ocm87/fmcw/README.md

# ELEC4907 FMCW/Dopper Radar Capstone Project
Year: 2024-2025

Supervisor: Shulabh Gupta

Team Members: Carter Livermore, Jin Her, Max Hecht, Owen MacIntosh
