ocm87/fmcw/post_processing/readme.md

This folder hold post processing applications for data received from the MCU over a serial UART connection at 921600 Baud
