ocm87/fmcw/hardware/kicad/CapstoneMCU/CapstoneMCU.step

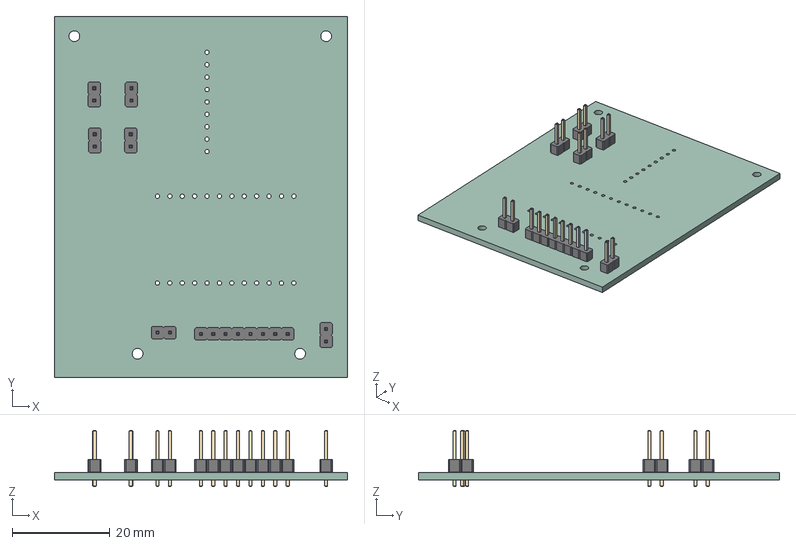
[picture p1: CAD file, 2025-04-09]
hardware/kicad/CapstoneMCU/CapstoneMCU.step
60.0 x 74.0 x 11.5 mm
PinHeader_1x02_P254mm_Vertical x 6
PinHeader_1x08_P254mm_Vertical
CapstoneMCU_PCB
