ocm87/fmcw/hardware/kicad/LF_Hardware/ELEC4907.step

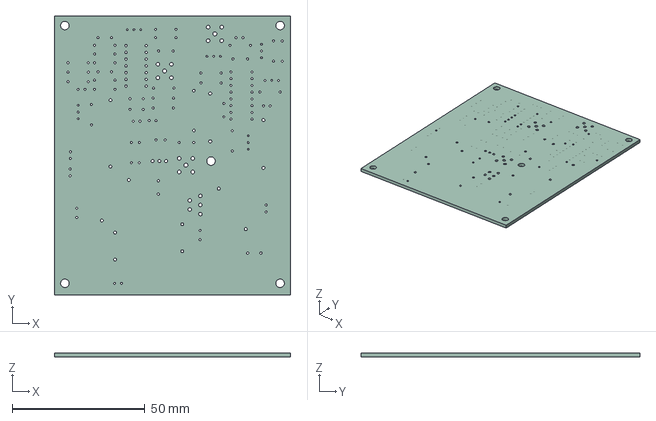
[picture p2: CAD file, 2025-04-09]
hardware/kicad/LF_Hardware/ELEC4907.step
89.0 x 105.0 x 1.60 mm
