ocm87/fmcw/hardware/kicad/symbols_and_footprints/mcu_pcb_symAndfoot/3296W_1_503LF/3296W-1-503LF.step

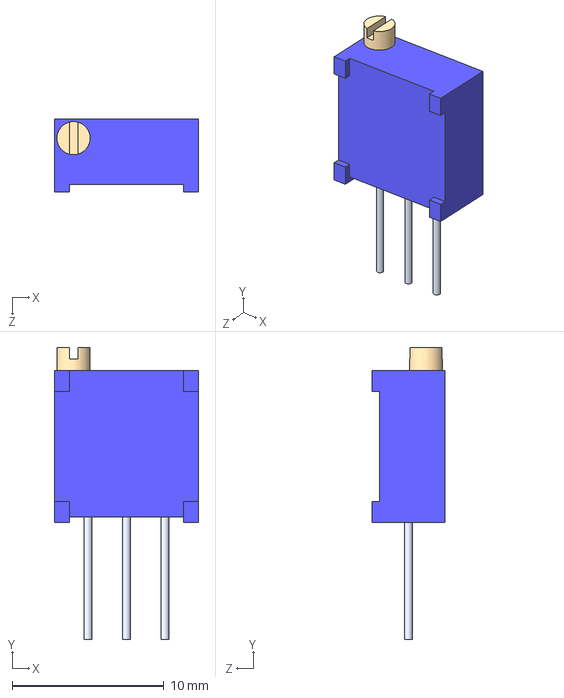
[picture p3: CAD file, 2025-04-09]
hardware/kicad/symbols_and_footprints/mcu_pcb_symAndfoot/3296W_1_503LF/3296W-1-503LF.step
9.53 x 19.3 x 4.83 mm
