ocm87/fmcw/hardware/kicad/symbols_and_footprints/mcu_pcb_symAndfoot/arm_debug_header/arm_debug_header.step

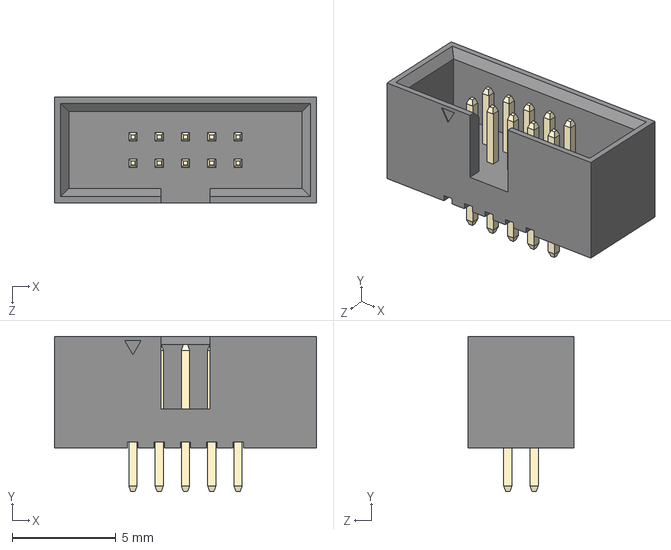
[picture p4: CAD file, 2025-04-09]
hardware/kicad/symbols_and_footprints/mcu_pcb_symAndfoot/arm_debug_header/arm_debug_header.step
12.7 x 7.50 x 5.10 mm
3220-xx-0100-00 body_10
Pin^3220-xx-0100-00 x 10
