ocm87/fmcw/hardware/kicad/symbols_and_footprints/mcu_pcb_symAndfoot/FTSH_105_01_LM_DV_K/FTSH-105-01-LM-DV-TR.step

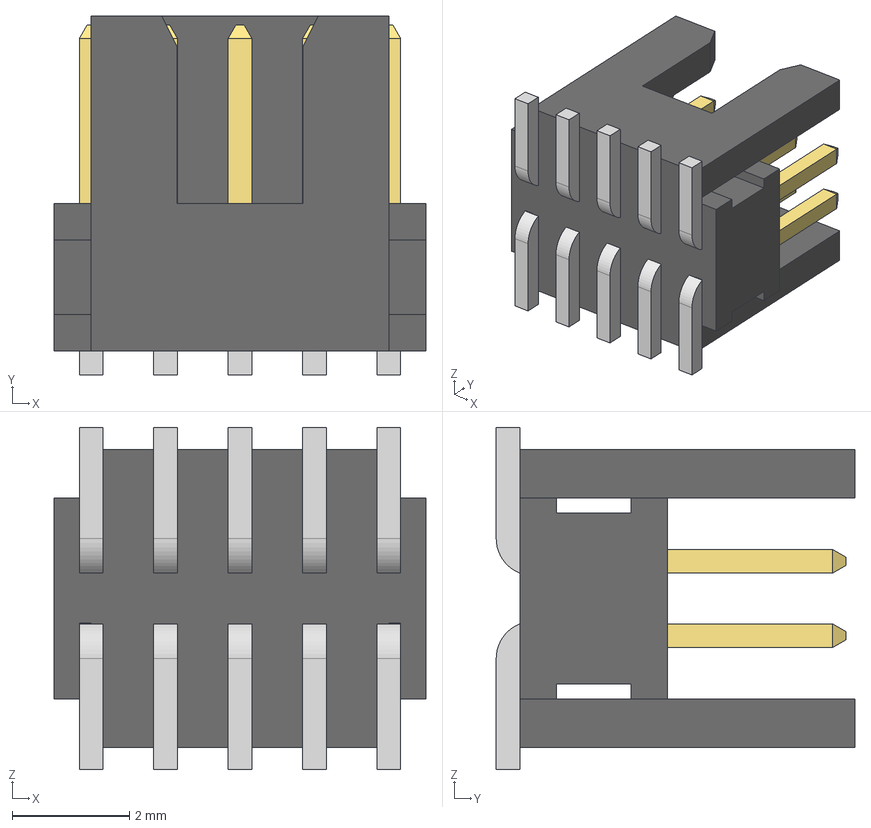
[picture p5: CAD file, 2025-04-09]
hardware/kicad/symbols_and_footprints/mcu_pcb_symAndfoot/FTSH_105_01_LM_DV_K/FTSH-105-01-LM-DV-TR.step
6.35 x 6.12 x 5.84 mm
FTSH-105-01-LM-DV-K_body
FTSH-105-01-LM-DV-K_pins1
FTSH-105-01-LM-DV-K_pins2
