ocm87/fmcw/hardware/kicad/symbols_and_footprints/mcu_pcb_symAndfoot/LT1214CN_PBF/PDIP-14_N_LIT.step

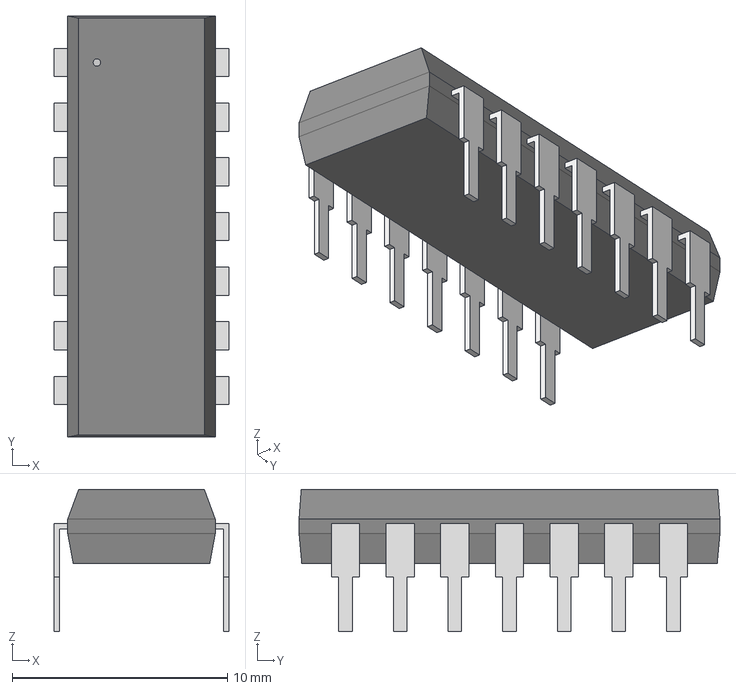
[picture p6: CAD file, 2025-04-09]
hardware/kicad/symbols_and_footprints/mcu_pcb_symAndfoot/LT1214CN_PBF/PDIP-14_N_LIT.step
8.13 x 19.6 x 6.61 mm
