ocm87/fmcw/(list of files, cad)

Other CAD files:
hardware/Top_level v55.f3z
