ocm87/fmcw/hardware/kicad/CapstoneMCU/CapstoneMCU.pdf

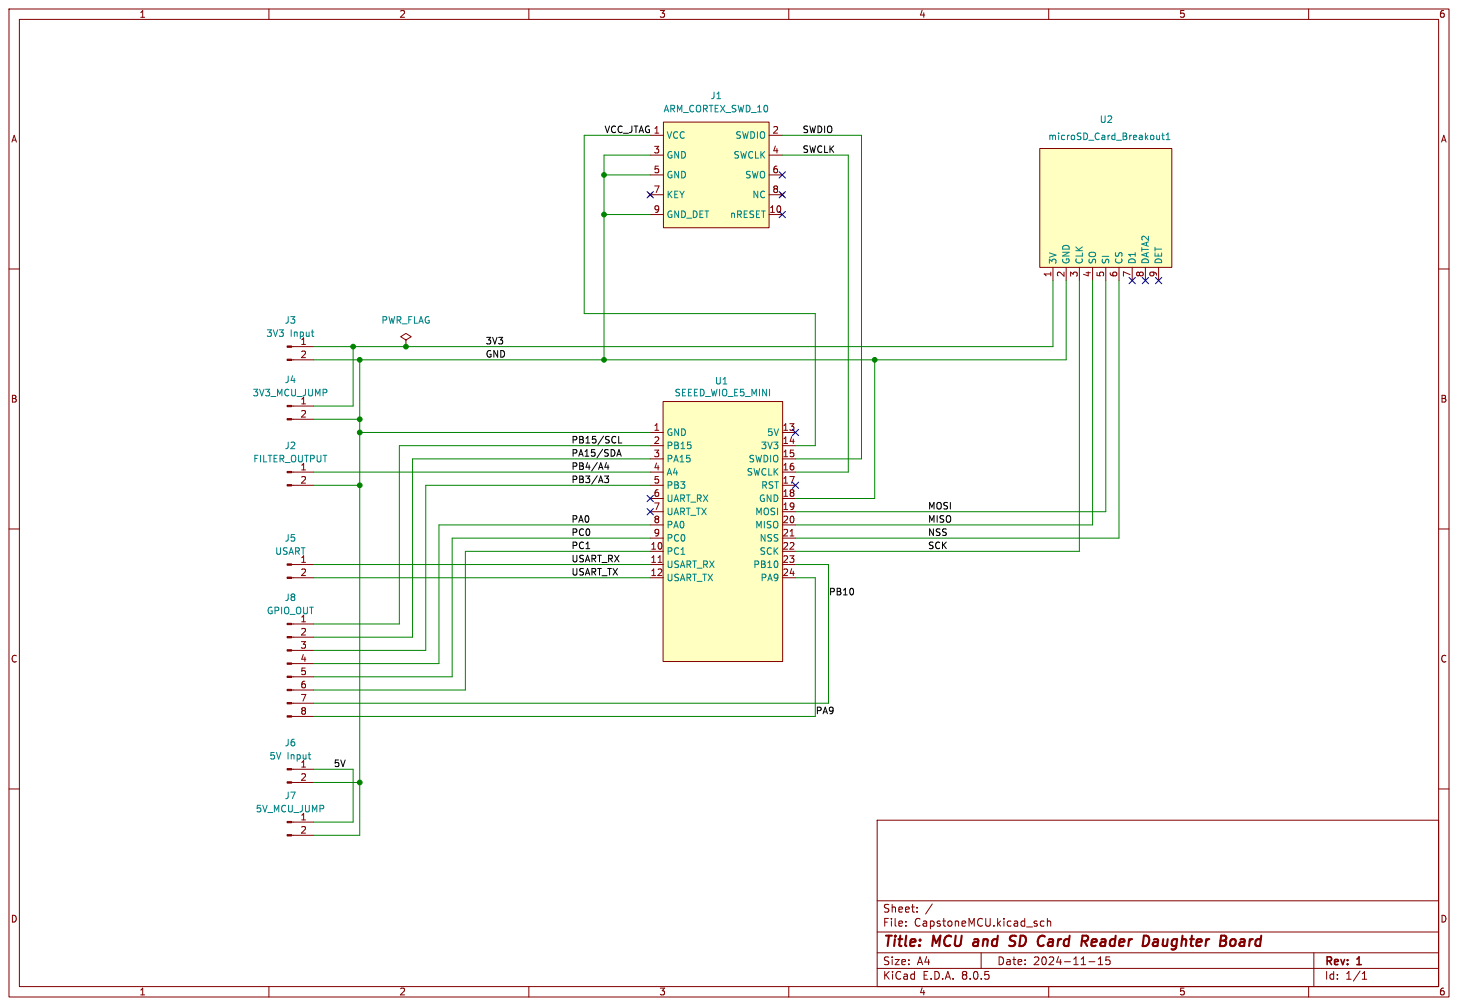
[picture p7: page 1]

Id: 1/1 Title: MCU and SD Card Reader Daughter Board
