ocm87/fmcw/hardware/kicad/LF_Hardware/ELEC4907.kicad_pcb

## KiCad design hardware/kicad/LF_Hardware/ELEC4907.kicad_pcb (2025-04-09)

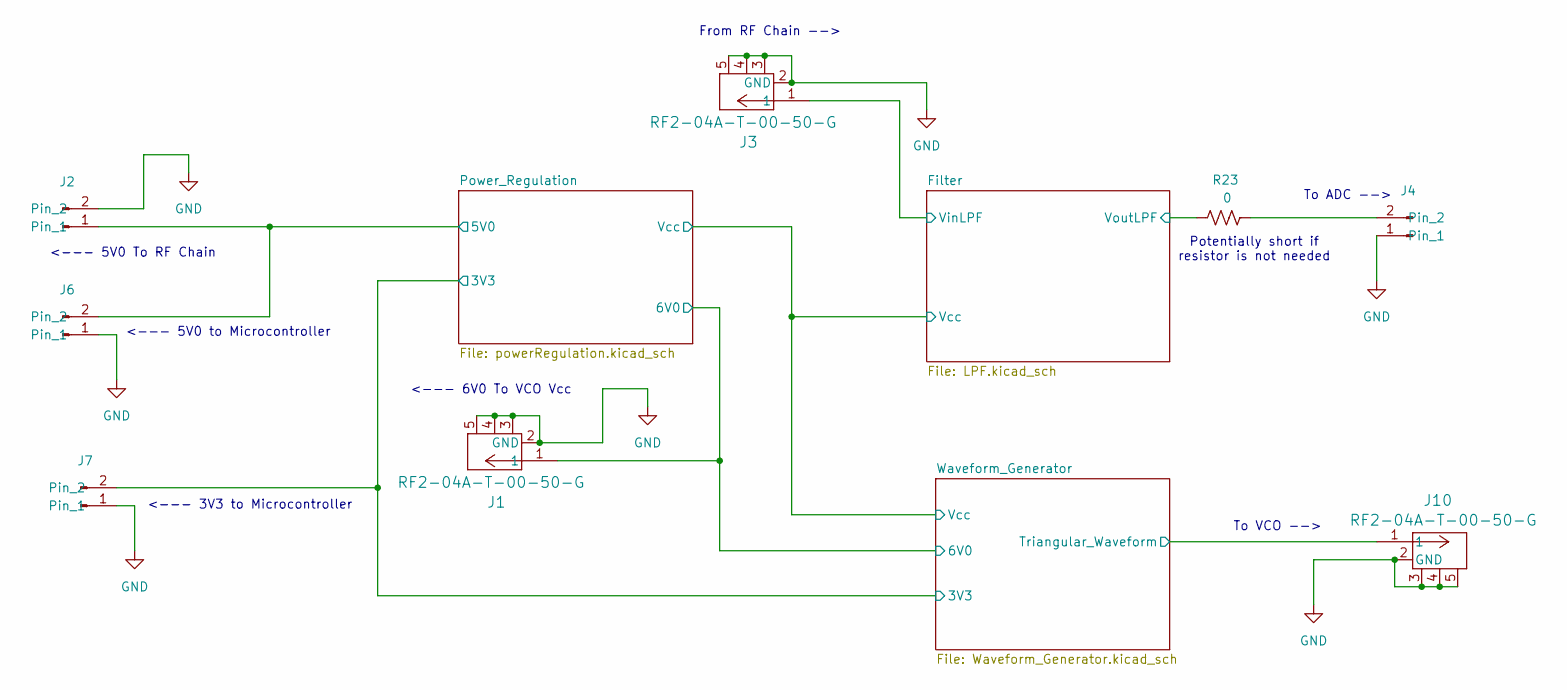
[picture p8: schematic ELEC4907.kicad_sch, Block Diagram - Carter Livermore]

Parts:
J1, J3, J10: RF2-04A-T-00-50-G; CONN_RF2-04A-T-00-50-G_ADM
J2, J4, J6, J7: 2-54mm_Spacing
R23: 0; resistor

Connections:
/Filter/VinLPF: J3.1; also elsewhere on the board
/Filter/VoutLPF: R23.1; also elsewhere on the board
/Power_Regulation/3V3: J7.2; also elsewhere on the board
/Power_Regulation/5V0: J2.1, J6.2; also elsewhere on the board
/Power_Regulation/6V0: J1.1; also elsewhere on the board
/Waveform_Generator/Triangular_Waveform: J10.1; also elsewhere on the board
GND: J1.2 (GND), J1.3, J1.4, J1.5, J2.2, J3.2 (GND), J3.3, J3.4, J3.5, J4.1, J6.1, J7.1, J10.2 (GND), J10.3, J10.4, J10.5; also elsewhere on the board
unnamed: J4.2, R23.2

Notes on the sheet:
From RF Chain -->
<--- 6V0 To VCO Vcc
<--- 3V3 to Microcontroller
<--- 5V0 To RF Chain
To VCO -->
Potentially short if resistor is not needed
To ADC -->
<--- 5V0 to Microcontroller

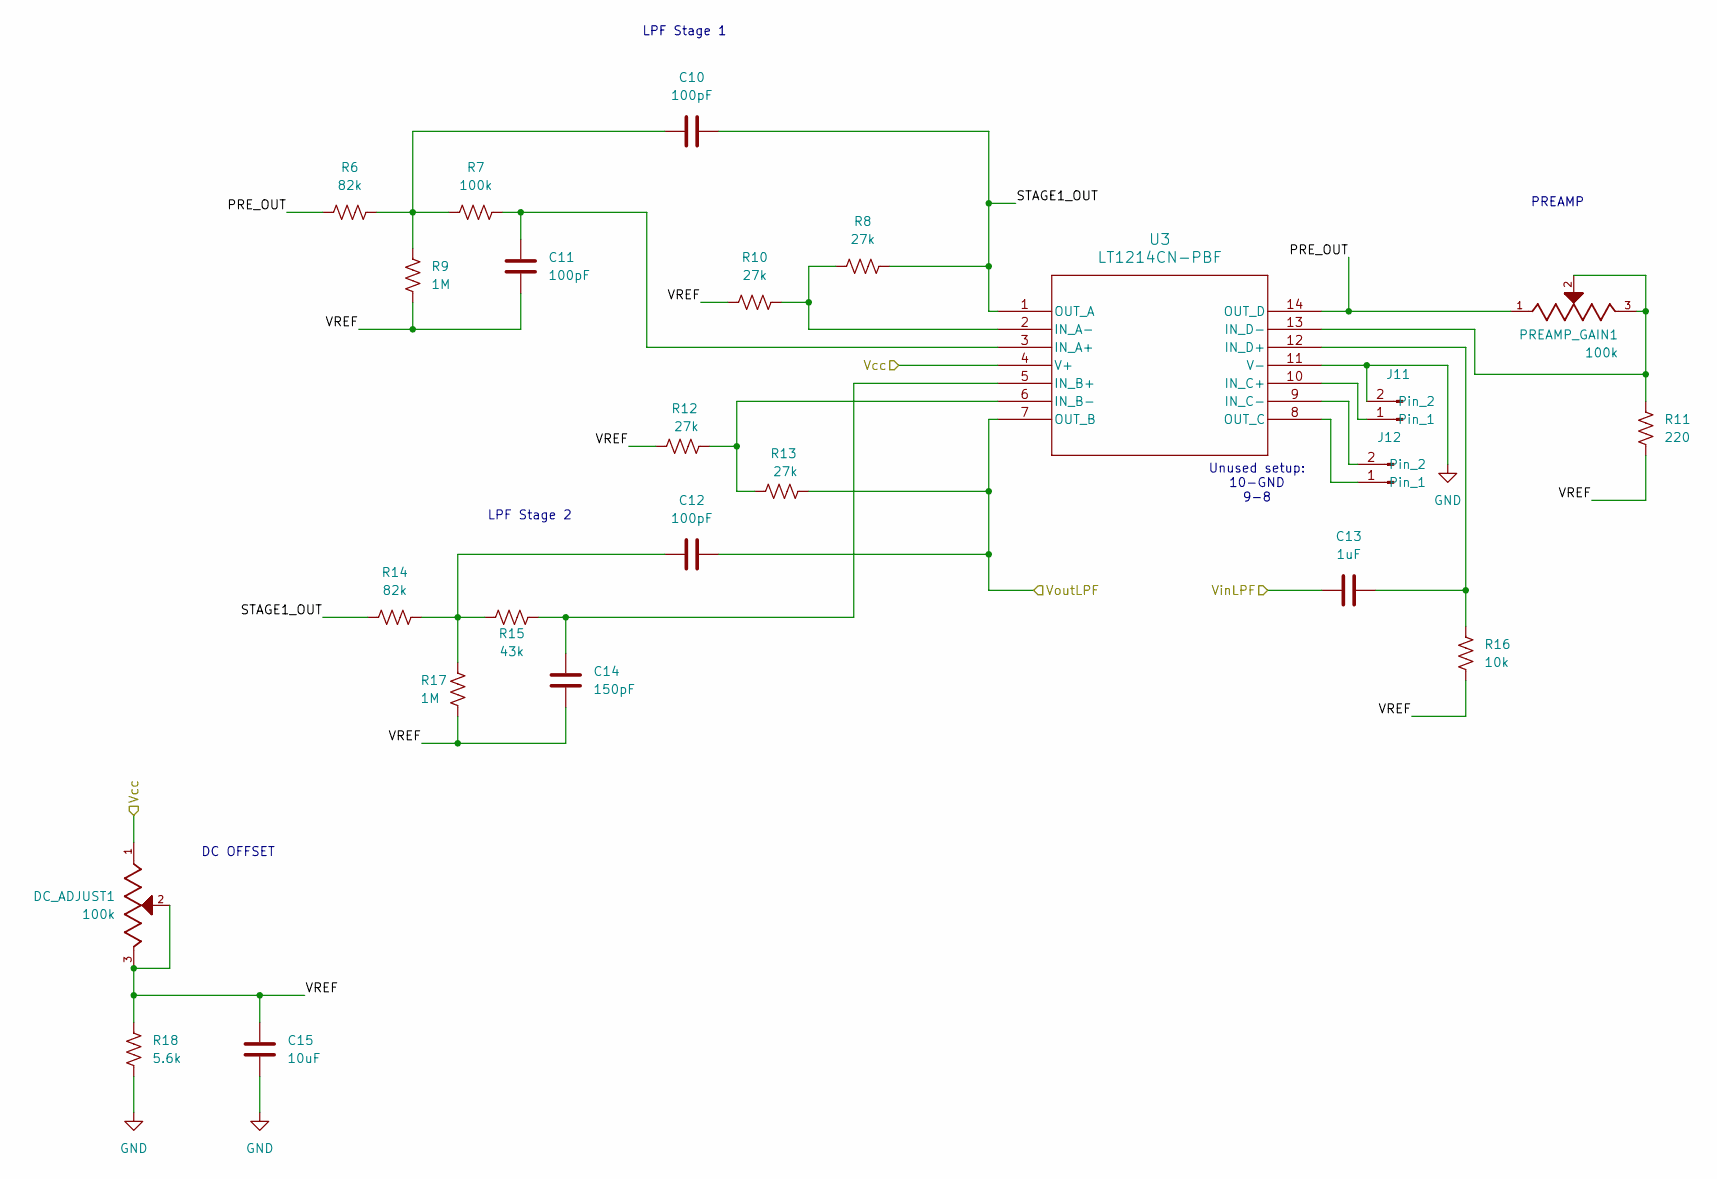
[picture p9: schematic LPF.kicad_sch, Low Pass Filter and Mixer Output Amplifier - Owen MacIntosh]

Parts:
C10, C11, C12: 100pF; Disc_Cap_P5mm
C13: 1uF; R82-D_KEM
C14: 150pF; Disc_Cap_P5mm
C15: 10uF; Axial_Cap_P25
DC_ADJUST1: 100k; TRIM_3296W-1-503LF; PARTREV 05/16
J11, J12: 2-54mm_Spacing
PREAMP_GAIN1: 100k; TRIM_3296W-1-503LF; PARTREV 05/16
R6, R14: 82k; resistor
R7: 100k; resistor
R8, R10, R12, R13: 27k; resistor
R9, R17: 1M; resistor
R11: 220; resistor
R15: 43k; resistor
R16: 10k; resistor
R18: 5.6k; resistor
U3: LT1214CN-PBF; PDIP-14_N_LIT

Connections:
/Filter/PRE_OUT: PREAMP_GAIN1.1, R6.1, U3.14 (OUT_D)
/Filter/STAGE1_OUT: C10.1, R8.2, R14.1, U3.1 (OUT_A)
/Filter/VREF: C11.1, C14.1, C15.1, DC_ADJUST1.2, DC_ADJUST1.3, R9.1, R10.1, R11.2, R12.1, R16.2, R17.1, R18.1
/Filter/Vcc: DC_ADJUST1.1, U3.4 (V+); also elsewhere on the board
/Filter/VinLPF: C13.1; also elsewhere on the board
/Filter/VoutLPF: C12.1, R13.2, U3.7 (OUT_B); also elsewhere on the board
GND: C15.2, J11.2, R18.2, U3.11 (V-); also elsewhere on the board
unnamed: C10.2, R6.2, R7.1, R9.2
unnamed: C12.2, R14.2, R15.1, R17.2
unnamed: J11.1, U3.10 (IN_C+)
unnamed: J12.1, U3.8 (OUT_C)
unnamed: J12.2, U3.9 (IN_C-)
unnamed: C11.2, R7.2, U3.3 (IN_A+)
unnamed: R8.1, R10.2, U3.2 (IN_A-)
unnamed: C14.2, R15.2, U3.5 (IN_B+)
unnamed: R12.2, R13.1, U3.6 (IN_B-)
unnamed: C13.2, R16.1, U3.12 (IN_D+)
unnamed: PREAMP_GAIN1.2, PREAMP_GAIN1.3, R11.1, U3.13 (IN_D-)

Notes on the sheet:
LPF Stage 2
PREAMP
LPF Stage 1
Unused setup: 10-GND 9-8
DC OFFSET

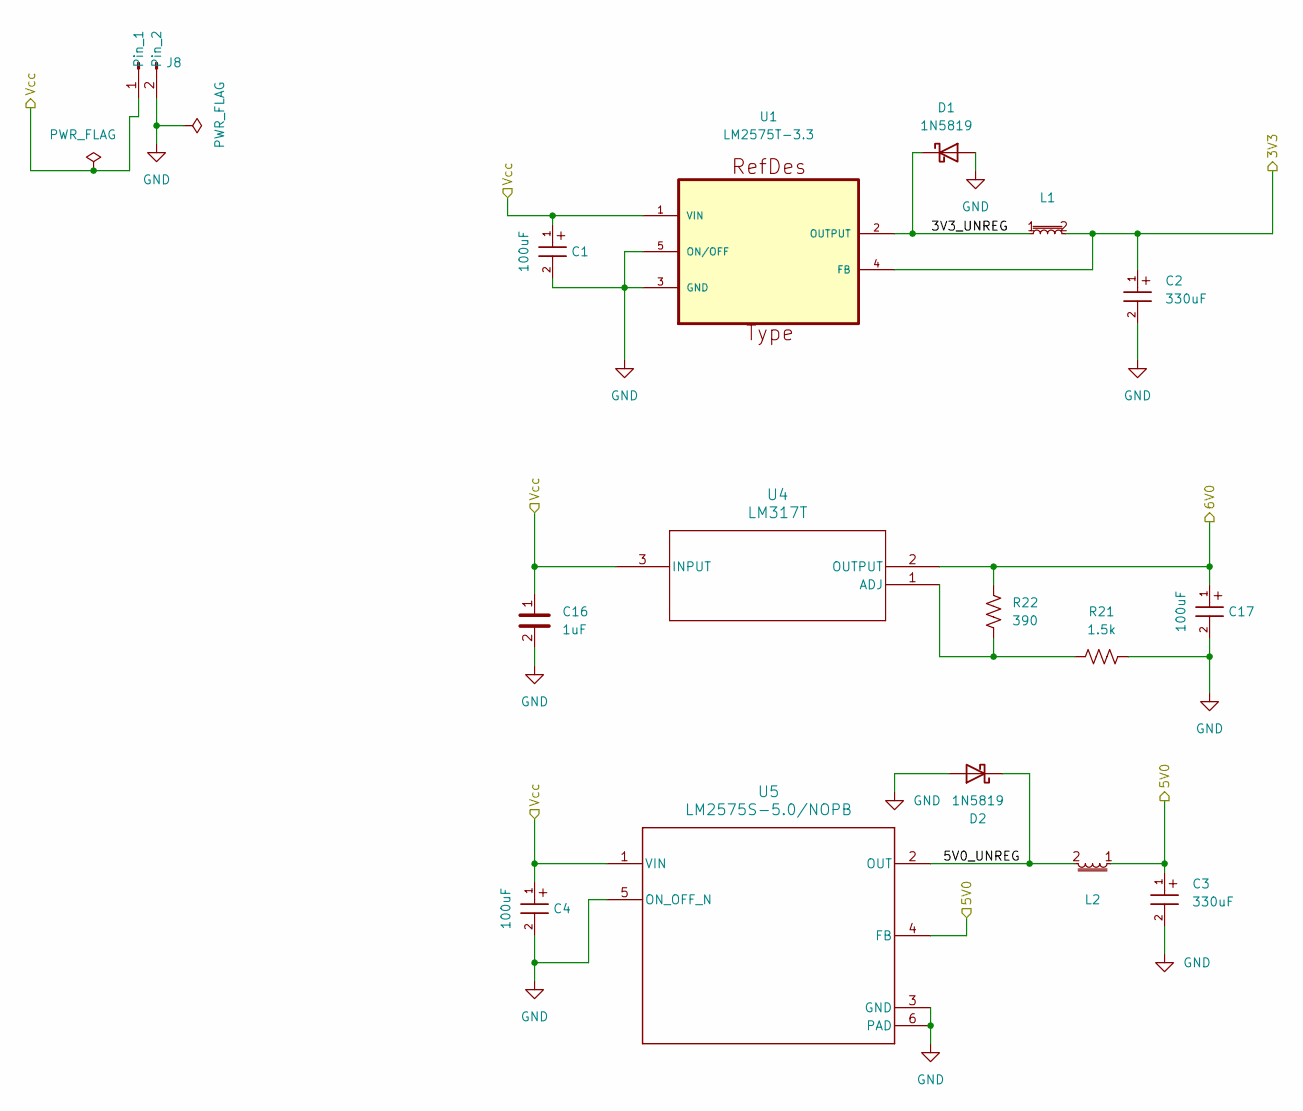
[picture p10: schematic powerRegulation.kicad_sch, Power Regulation - Carter Livermore]

Parts:
C1, C4, C17: 100uF; 100uF_RadialCap
C2, C3: 330uF; 330uF_radialCap
C16: 1uF; R82-D_KEM
D1, D2: 1N5819; D_DO-41_SOD81_P10.16mm_Horizontal
J8: 2-54mm_Spacing
L1: IND_PE-526xx_V_PUL
L2: 330uH Inductor
R21: 1.5k; resistor
R22: 390; resistor
U1: LM2575T-3.3; (3v3)TO170P470X1016X2092-5P; MPN LM2575T-3.3
U4: LM317T; TO-220_STM
U5: LM2575S-5.0/NOPB; KTT0005B

Connections:
/Filter/Vcc: C1.1, C4.1, C16.1, J8.1, U1.1 (VIN), U4.3 (INPUT), U5.1 (VIN); also elsewhere on the board
/Power_Regulation/3V3: C2.1, L1.2, U1.4 (FB); also elsewhere on the board
/Power_Regulation/3V3_UNREG: D1.1 (K), L1.1, U1.2 (OUTPUT)
/Power_Regulation/5V0: C3.1, L2.1, U5.4 (FB); also elsewhere on the board
/Power_Regulation/5V0_UNREG: D2.1 (K), L2.2, U5.2 (OUT)
/Power_Regulation/6V0: C17.1, R22.2, U4.2 (OUTPUT); also elsewhere on the board
GND: C1.2, C2.2, C3.2, C4.2, C16.2, C17.2, D1.2 (A), D2.2 (A), J8.2, R21.2, U1.3 (GND), U1.5 (ON/OFF), U5.3 (GND), U5.5 (ON_OFF_N), U5.6 (PAD); also elsewhere on the board
unnamed: R21.1, R22.1, U4.1 (ADJ)

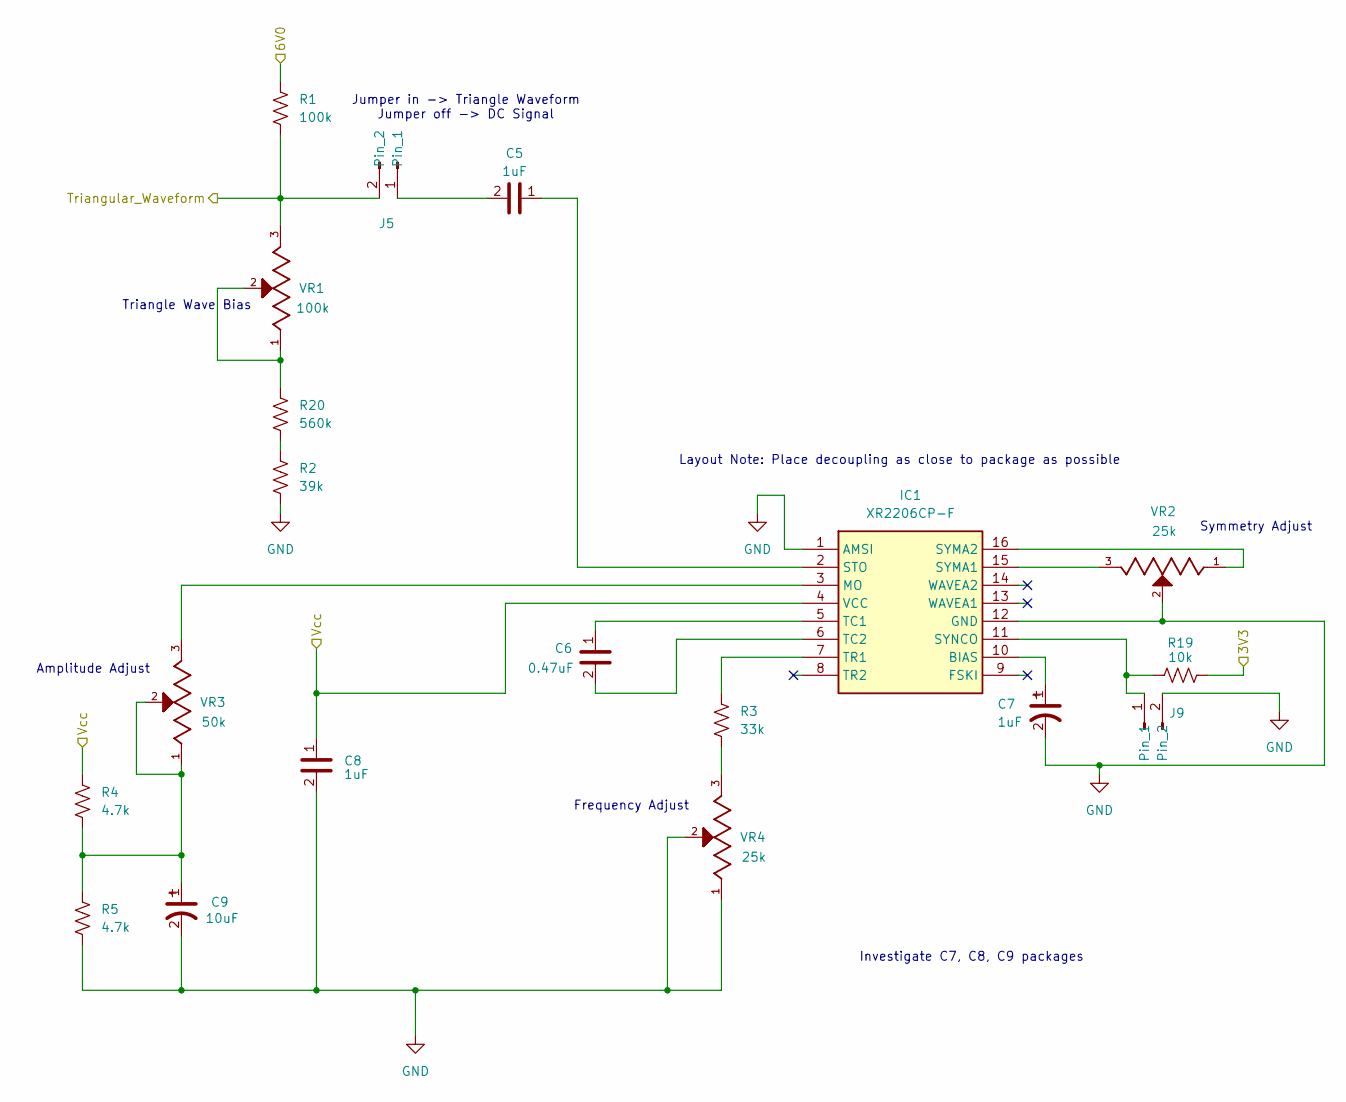
[picture p11: schematic Waveform_Generator.kicad_sch, Waveform Generator - C.L and O.M]

Parts:
C5: 1uF; R82-D_KEM
C6: 0.47uF; 0.47uF_cap
C7, C8: 1uF; AxialCap_P18
C9: 10uF; Cap_P15
IC1: XR2206CP-F; DIP794W56P254L2013H533Q16N; Manufacturer_Part_Number XR2206CP-F; Mouser Part Number 701-XR2206CP-F
J5, J9: 2-54mm_Spacing
R1: 100k; resistor
R2: 39k; resistor
R3: 33k; resistor
R4, R5: 4.7k; resistor
R19: 10k; resistor
R20: 560k; resistor
VR1: 100k; TRIM_3296W-1-503LF; PARTREV 05/16
VR2, VR4: 25k; TRIM_3296W-1-503LF; PARTREV 05/16
VR3: 50k; TRIM_3296W-1-503LF; PARTREV 05/16

Connections:
/Filter/Vcc: C8.1, IC1.4 (VCC), R4.1; also elsewhere on the board
/Power_Regulation/3V3: R19.2; also elsewhere on the board
/Power_Regulation/6V0: R1.1; also elsewhere on the board
/Waveform_Generator/Triangular_Waveform: J5.2, R1.2, VR1.3; also elsewhere on the board
GND: C7.2, C8.2, C9.2, IC1.1 (AMSI), IC1.12 (GND), J9.2, R2.2, R5.2, VR2.2, VR4.1, VR4.2; also elsewhere on the board
unnamed: C9.1, R4.2, R5.1, VR3.1, VR3.2
unnamed: C7.1, IC1.10 (BIAS)
unnamed: IC1.3 (MO), VR3.3
unnamed: C5.1, IC1.2 (STO)
unnamed: IC1.15 (SYMA1), VR2.3
unnamed: IC1.16 (SYMA2), VR2.1
unnamed: IC1.11 (SYNCO), J9.1, R19.1
unnamed: C6.1, IC1.5 (TC1)
unnamed: C6.2, IC1.6 (TC2)
unnamed: IC1.7 (TR1), R3.1
unnamed: C5.2, J5.1
unnamed: R2.1, R20.2
unnamed: R3.2, VR4.3
unnamed: R20.1, VR1.1, VR1.2

Notes on the sheet:
Jumper in -> Triangle Waveform Jumper off -> DC Signal
Frequency Adjust
Investigate C7, C8, C9 packages
Layout Note: Place decoupling as close to package as possible
Amplitude Adjust
Triangle Wave Bias
Symmetry Adjust

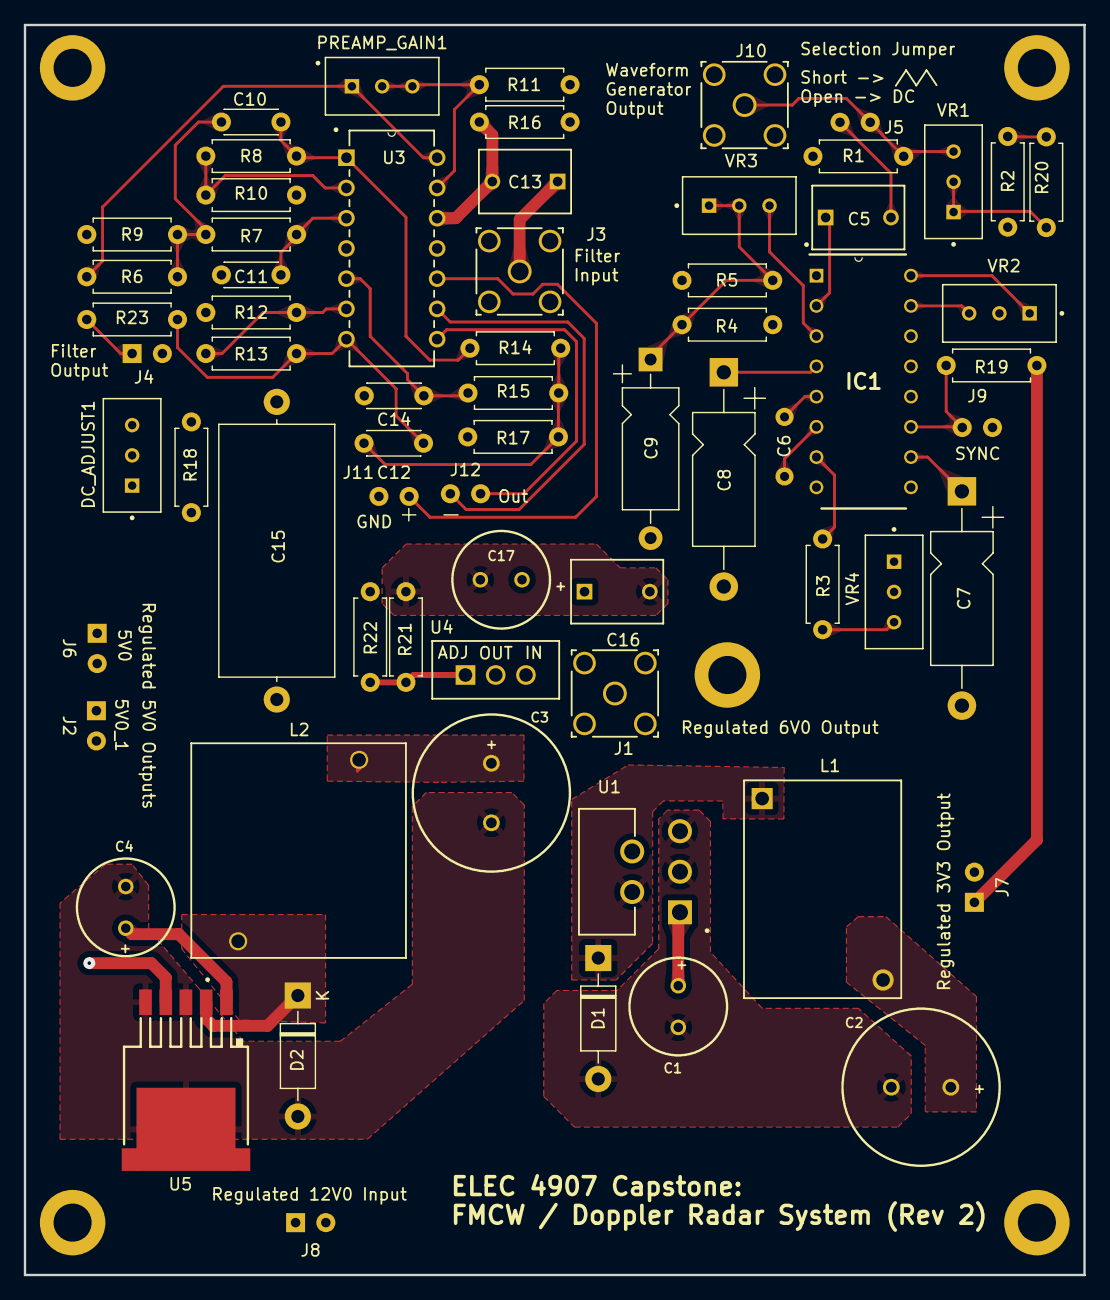
[picture p12: board ELEC4907.kicad_pcb from above]

Board: 4 copper layers, 89.0 x 105.0 mm, 71 parts (0 on the bottom side), 40 nets.

Other parts of the board:
GND: MountingHole_3.2mm_M3_ISO14580_Pad
GND#2, GND#3, GND#4: MountingHole_3.2mm_M3_ISO14580_Pad

Their connections:
GND: GND.1, GND#2.1, GND#3.1, GND#4.1; also elsewhere on the board
