ocm87/fmcw/hardware/kicad/CapstoneMCU/CapstoneMCU.kicad_pcb

## KiCad design hardware/kicad/CapstoneMCU/CapstoneMCU.kicad_pcb (2025-04-09)

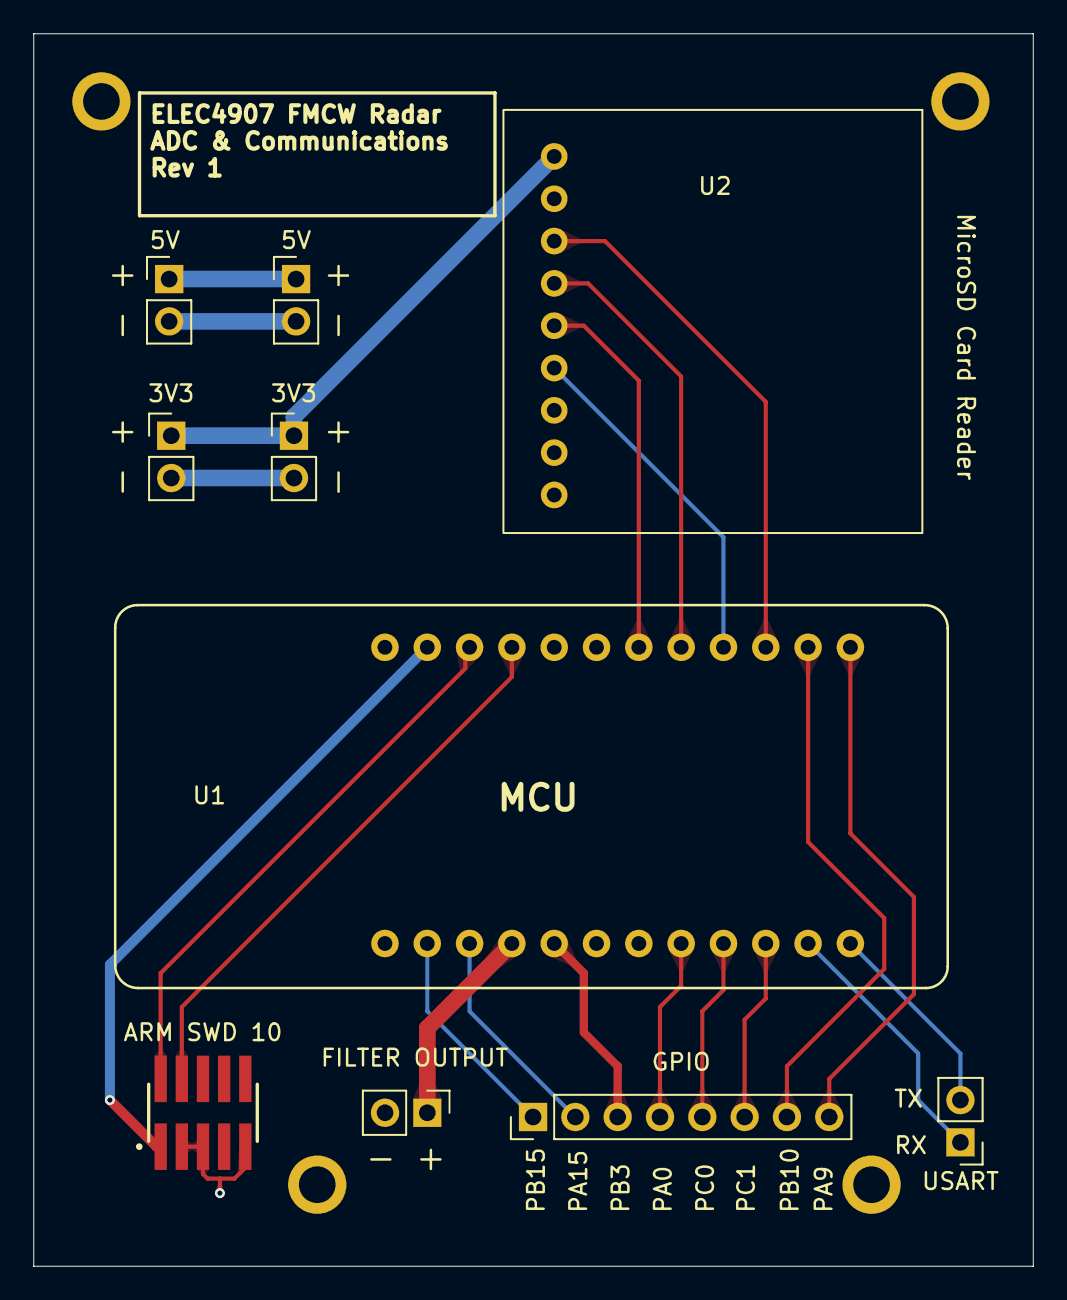
[picture p13: board CapstoneMCU.kicad_pcb from above]

Board: 4 copper layers, 60.0 x 74.0 mm, 10 parts (0 on the bottom side), 21 nets.

Parts:
3V3: 3V3_MCU_JUMP; PinHeader_1x02_P2.54mm_Vertical
3V3#2: 3V3 Input; PinHeader_1x02_P2.54mm_Vertical
5V: 5V_MCU_JUMP; PinHeader_1x02_P2.54mm_Vertical
5V#2: 5V Input; PinHeader_1x02_P2.54mm_Vertical
ARM SWD 10: ARM_CORTEX_SWD_10; SAMTEC_FTSH-105-01-LM-DV-TR
FILTER OUTPUT: FILTER_OUTPUT; PinHeader_1x02_P2.54mm_Vertical
GPIO: GPIO_OUT; PinHeader_1x08_P2.54mm_Vertical
U1: SEEED_WIO_E5_MINI; Wio_e5
U2: microSD_Card_Breakout1; adafruit_sd_card_spi
USART: USART; PinHeader_1x02_P2.54mm_Vertical

Connections:
/3V3: 3V3.1, 3V3#2.1, U2.1 (3V)
/5V: 5V.1, 5V#2.1
/GND: 3V3.2, 3V3#2.2, 5V.2, 5V#2.2, ARM SWD 10.3 (GND), ARM SWD 10.5 (GND), ARM SWD 10.9 (GND_DET), FILTER OUTPUT.2, U1.1 (GND), U1.18 (GND), U2.2 (GND)
/MISO: U1.20 (MISO), U2.4 (SO)
/MOSI: U1.19 (MOSI), U2.5 (SI)
/NSS: U1.21 (NSS), U2.6 (CS)
/PA0: GPIO.4, U1.8 (PA0)
/PA9: GPIO.8, U1.24 (PA9)
/PA15/SDA: GPIO.2, U1.3 (PA15)
/PB3/A3: GPIO.3, U1.5 (PB3)
/PB4/A4: FILTER OUTPUT.1, U1.4 (A4)
/PB10: GPIO.7, U1.23 (PB10)
/PB15/SCL: GPIO.1, U1.2 (PB15)
/PC0: GPIO.5, U1.9 (PC0)
/PC1: GPIO.6, U1.10 (PC1)
/SCK: U1.22 (SCK), U2.3 (CLK)
/SWCLK: ARM SWD 10.4 (SWCLK), U1.16 (SWCLK)
/SWDIO: ARM SWD 10.2 (SWDIO), U1.15 (SWDIO)
/USART_RX: U1.11 (USART_RX), USART.1
/USART_TX: U1.12 (USART_TX), USART.2
/VCC_JTAG: ARM SWD 10.1 (VCC), U1.14 (3V3)
