ocm87/fmcw/stm/e5_double_sample/Core/Src/main.c

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
/* Includes ------------------------------------------------------------------*/
#include "main.h"

/* USER CODE BEGIN Includes */
#include <inttypes.h>
/* USER CODE END Includes */

/* USER CODE BEGIN PD */
#define ADC_BUF_LEN 26624
/* USER CODE END PD */

/* USER CODE BEGIN PM */
#define PUTCHAR_PROTOTYPE int __io_putchar(int ch)
/* USER CODE END PM */

ADC_HandleTypeDef hadc;
DMA_HandleTypeDef hdma_adc;

UART_HandleTypeDef huart1;

/* USER CODE BEGIN PV */
volatile uint16_t adc_buf[ADC_BUF_LEN];
int dma_trigger;
/* USER CODE END PV */

void SystemClock_Config(void);
static void MX_GPIO_Init(void);
static void MX_DMA_Init(void);
static void MX_ADC_Init(void);
static void MX_USART1_UART_Init(void);
/* USER CODE BEGIN PFP */
void dump_buffer_uart(uint16_t *buf_ptr, uint32_t buf_length, int* dma_trigger);
/* USER CODE END PFP */

/**
  * @brief  The application entry point.
  * @retval int
  */
int main(void)
{

  /* MCU Configuration--------------------------------------------------------*/

  /* Reset of all peripherals, Initializes the Flash interface and the Systick. */
  HAL_Init();

  /* Configure the system clock */
  SystemClock_Config();

  /* Initialize all configured peripherals */
  MX_GPIO_Init();
  MX_DMA_Init();
  MX_ADC_Init();
  MX_USART1_UART_Init();
  /* USER CODE BEGIN 2 */
  dma_trigger = 0;
  HAL_ADC_Start_DMA(&hadc, (uint32_t*)adc_buf, ADC_BUF_LEN);
  /* USER CODE END 2 */

  /* Infinite loop */
  /* USER CODE BEGIN WHILE */
  while (1)
  {
	  if (dma_trigger == 1) {
		dma_trigger = 0;
		HAL_ADC_Start_DMA(&hadc, (uint32_t*)adc_buf, ADC_BUF_LEN);
	  }
    /* USER CODE END WHILE */

    /* USER CODE BEGIN 3 */
  }
  /* USER CODE END 3 */
}

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
/* USER CODE BEGIN 4 */
PUTCHAR_PROTOTYPE {
  HAL_UART_Transmit(&huart1, (uint8_t *)&ch, 1, 0xFFFF);
  return ch;
}

// Called when buffer is completely filled
void HAL_ADC_ConvCpltCallback(ADC_HandleTypeDef* hadc) {
	HAL_GPIO_WritePin(LED_BANK, LED_PIN, GPIO_PIN_SET);
    dump_buffer_uart((uint16_t*)adc_buf, ADC_BUF_LEN, &dma_trigger);
    HAL_GPIO_WritePin(LED_BANK, LED_PIN, GPIO_PIN_RESET);
    // stop DMA process so it can be restarted
    HAL_ADC_Stop_DMA(hadc);
}

void dump_buffer_uart(uint16_t *buf_ptr, uint32_t buf_length, int* dma_trigger) {
	// TODO: Change start and stop signals to all ones
	printf("START\n");
	for (int i = 0; i < buf_length; i++) {
			printf("%" PRIu16 "\n", buf_ptr[i]);
		}
	printf("END\n");
	// signal that next DMA transfer can take place
	*dma_trigger = 1;
}
/* USER CODE END 4 */
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
