ocm87/fmcw/stm/e5_double_sample/e5_double_sample.ioc

Mcu.UserName=STM32WL55JCIx
PB3.Signal=ADC_IN2
PB4.Signal=ADC_IN3
PB5.Signal=GPIO_Output
PB6.Signal=USART1_TX
PB7.Signal=USART1_RX
