ocm87/fmcw/(commit log)

2025-04-05 added stm32 projects with basic programming instructions
2025-04-09 added KiCad project and gerber files for MCU breakout pcb
    [CapstoneMCU-B_Cu.gbl, CapstoneMCU-B_Mask.gbs, CapstoneMCU-B_Silkscreen.gbo, CapstoneMCU-Edge_Cuts.gm1, CapstoneMCU-F_Cu.gtl, CapstoneMCU-F_Mask.gts, CapstoneMCU-F_Silkscreen.gto, CapstoneMCU-NPTH.drl]
2025-04-09 Added LF Hardware KiCad Project
    This is the schematic and PCB for the LF hardware circuit.
    [CapstoneMCU.step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]
2025-04-09 bom added
    [3296W-1-503LF.step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]
2025-04-09 moved mcu symbols
    [3296W-1-503LF.step, FTSH-105-01-LM-DV-TR.step, PDIP-14_N_LIT.step, arm_debug_header.step]
2025-04-15 Added Fusion 360 Archive file for Chassis.
    [Top_level v55.f3z]
