ocm87/fmcw/(notices)

Notices in the files:
stm/e5_double_sample/Core/Src/main.c:
Copyright (c) 2025 STMicroelectronics.
All rights reserved.
This software is licensed under terms that can be found in the LICENSE file
hardware/kicad/symbols_and_footprints/mcu_pcb_symAndfoot/FTSH_105_01_LM_DV_K/FTSH-105-01-LM-DV-TR.step:
author */ ('License CC BY-ND 4.0'),
